inezamizero/step-counter/(commit log)

2026-10-05 Step counter: LIS3DH + LilyGO T-QT (ESP32-S3)
    Register-level LIS3DH driver, 50 Hz data-ready sampling, step detection
    tuned on recorded walking data (v1 fixed threshold, v2 adaptive), display,
    flash persistence, and a Bluetooth LE step service.
    [walk_20_steps.csv]
2026-10-05 Testable detector module, wiring diagram, honest validation status
    - Move the step algorithm into step_detector.h (no Arduino dependencies)
    - Add a desktop test that compiles the same file and replays the recording
    - Make the reset button non-blocking so sampling continues while it is held
    - Add a wiring diagram and I2C pull-up / bus speed notes
    - Clarify that accuracy so far is on the tuning recording; plan held-out tests
